JarnoBoks/spacemouse/pcb/esp32s3zero - rev1.0/PCB_CAD-Mouse_rev1.0.dxf

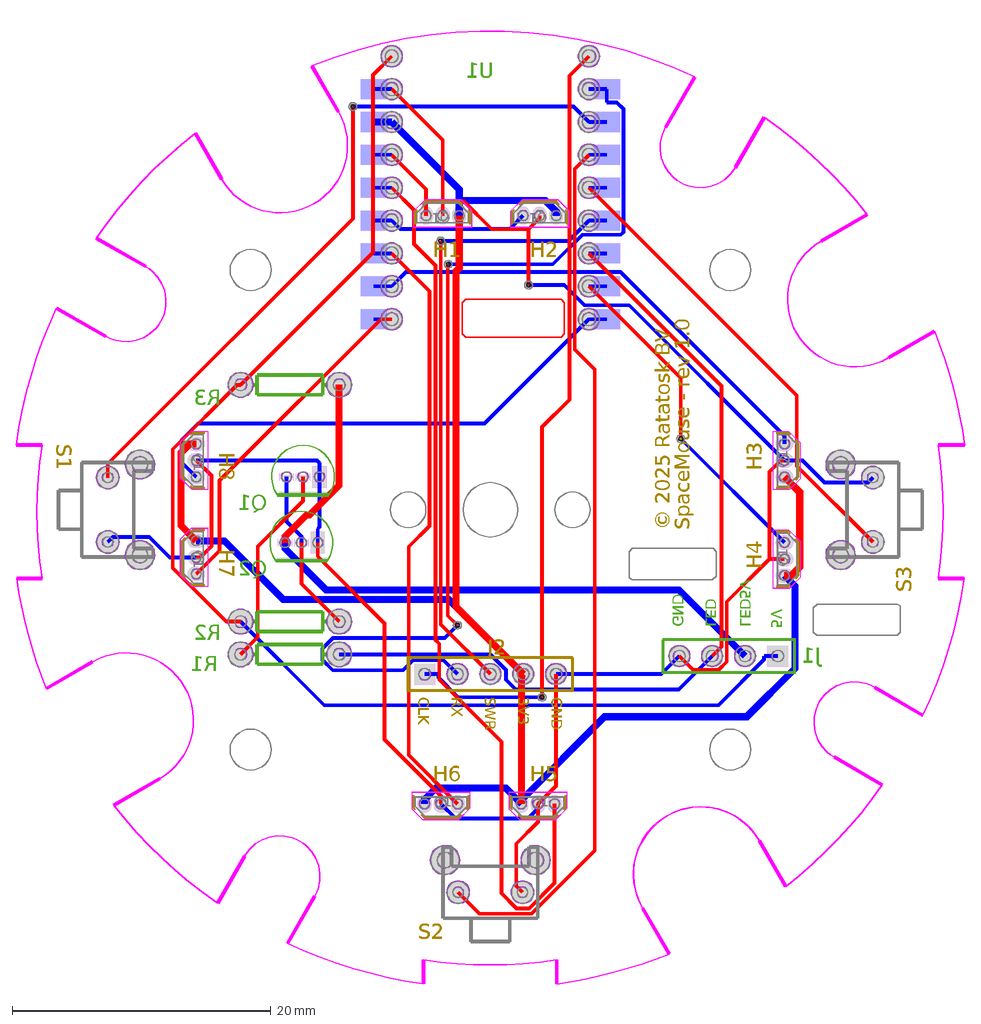
[picture p1: CAD file, 2025-06-10]
pcb/esp32s3zero - rev1.0/PCB_CAD-Mouse_rev1.0.dxf
LED
LED5V
5V
GND
CLK
RX
SWR
3V3
SpaceMouse - rev 1.0
© 2025 Ratatosk BV
U1
Q1
Q2
R1
R2
R3
H1
H2
H3
H4
H5
H6
H7
H8
J1
J2
S1
S2
S3
