JarnoBoks/spacemouse/stl/Spacer - PCB Sensorplate.stl

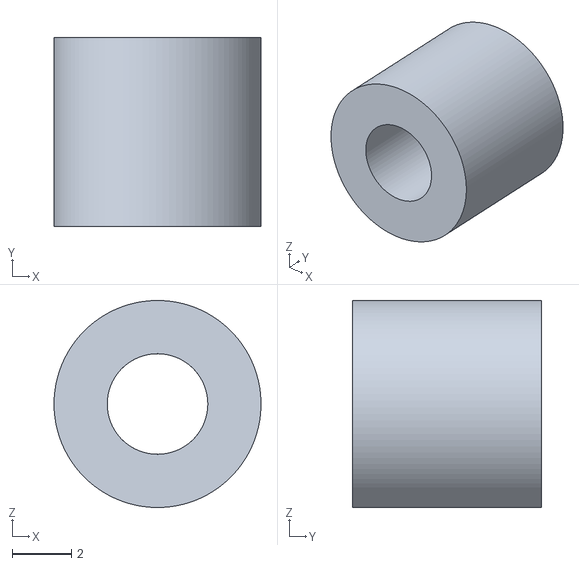
[picture p2: CAD file, 2025-06-10]
stl/Spacer - PCB Sensorplate.stl
7.00 x 6.40 x 7.00
