JarnoBoks/spacemouse/stl/Modified Arduino Plate.stl

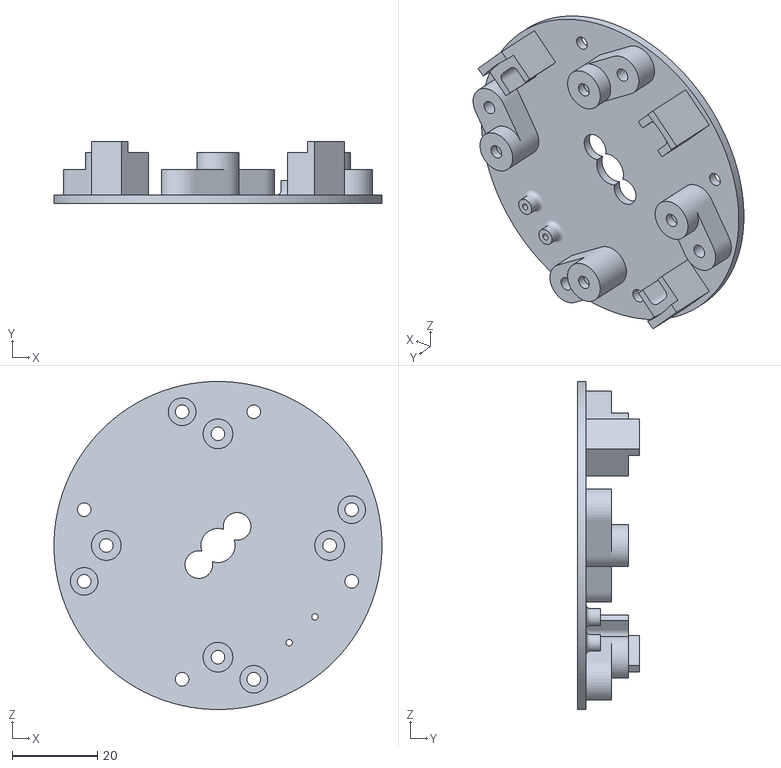
[picture p3: CAD file, 2025-06-10]
stl/Modified Arduino Plate.stl
77.0 x 14.5 x 77.0
