JarnoBoks/spacemouse/stl/Bolt mount.stl

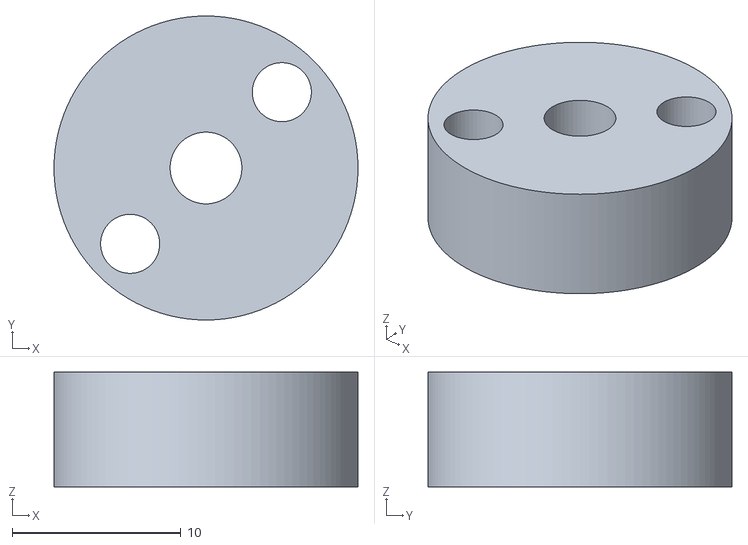
[picture p4: CAD file, 2025-06-10]
stl/Bolt mount.stl
18.0 x 18.0 x 6.80
