JarnoBoks/spacemouse/pcb/esp32s3zero - rev1.0/Gerber_CAD-Mouse_PCB_CAD-Mouse_2025-05-26/How-to-order-PCB.txt

How to Order PCB

Please refer to:
https://docs.easyeda.com/en/PCB/Order-PCB
