JarnoBoks/spacemouse/pcb/esp32s3zero - rev1.0/Schematic_CAD-Mouse_2025-05-26.pdf

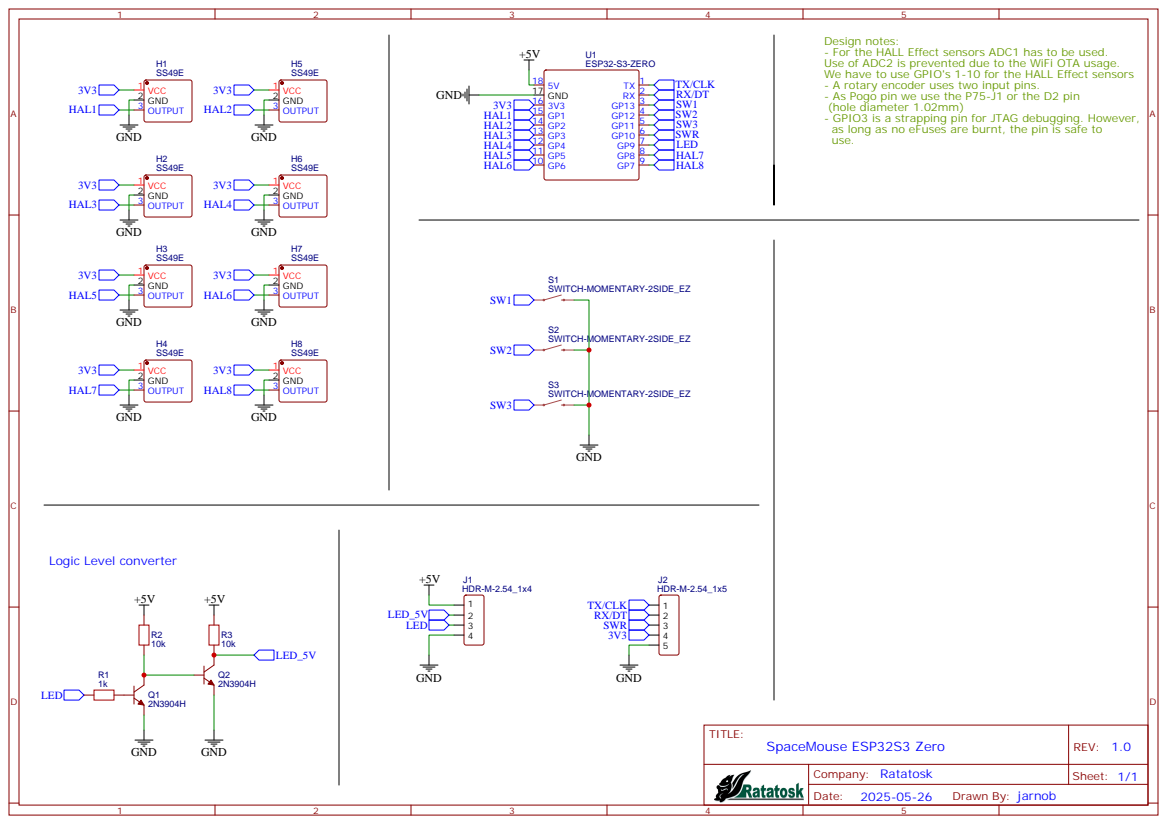
[picture p5: page 1]

Design notes:
- For the HALL Effect sensors ADC1 has to be used.
Use of ADC2 is prevented due to the WiFi OTA usage.
We have to use GPIO's 1-10 for the HALL Effect sensors
- A rotary encoder uses two input pins.
- As Pogo pin we use the P75-J1 or the D2 pin
(hole diameter 1.02mm)
- GPIO3 is a strapping pin for JTAG debugging. However,
as long as no eFuses are burnt, the pin is safe to
use.
