JarnoBoks/spacemouse/(list of files, drawings)

Other design files:
pcb/esp32s3zero - rev1.0/EasyEda SCH_CAD-Mouse_2025-05-26.json
