JarnoBoks/spacemouse/src/sensor/sensors/Sensor.cpp

#include "Sensor.hpp"
#include <sensor/config/SensorConfig.hpp>
#include <sensor/sensors/ArchitectureADC.hpp> // Abstraction from Architecture specific ADC functions

#include <wiring_private.h> // for 'map' function

/**
 * @brief Constructor for Sensor.
 * @details Initializes the sensor with the provided pin and ID.
 *          The constructor also creates a new SensorConfig object for this axis.
 * @param pin The pin number for the sensor.
 * @param id The ID of the sensor.
 */
Sensor::Sensor(const int8_t pin, const int8_t id)
    : pin(pin),
      id(id),
      config(new SensorConfig(this)) {

    // Configure this sensor's pin for ADC reading
    ArchitectureADC::connectADC(pin);

    // Read the ADC value from the pin to stabilize the ADC reading
    readValue();
}

Sensor::~Sensor() {
    delete config;
}

/**
 * @brief Checks if the provided descriptor matches the sensor's descriptor.
 * @param descriptor The descriptor to compare against the sensor's descriptor.
 * @return True if the descriptors match, false otherwise.
 */
const bool Sensor::hasDescriptor(const char *descriptor) const {
    if (this->descriptor != nullptr) {
        return (strcmp(this->descriptor, descriptor) == 0);
    }
    return false;
}

/**
 * @brief Reads the raw value from the sensor pin and applies centering if the configuration is set.
 * @details This function reads the analog value from the specified pin and calculates the centered value.
 *          If a configuration is set, it adjusts the centered value based on the idle position.
 */
void Sensor::readValue() {
    m_rawValue = ArchitectureADC::readADC(pin);

    if (config) { // REVIEW - Why the check for config?
        m_cntValue = m_rawValue - m_idleposition;
    }
}

/**
 * @brief Sets the idle position for the sensor.
 * @note This function should be called by descendants.
 *       It is intended to be overridden by derived classes to implement specific idle position logic.
 * @param val The new idle position to set.
 * @return False if any warning occurs, True otherwise.
 */
bool Sensor::setIdlePosition(int val) {
    m_idleposition = val; // Set the idle position to the provided value
    if (config) {
        config->processCenterChange(val); // Adjust the min and max values in the configuration based on the new idle position
    }
    return true; // Return true to indicate success
}

/**
 * @brief Sets the deadzone for the sensor.
 * @note This function is a placeholder and does not perform any validation.
 *       It is intended to be overridden by derived classes to implement specific deadzone logic.
 * @param val The new deadzone to set.
 * @return False if no warning occurs, True otherwise.
 */
bool Sensor::setDeadzone(const uint8_t dz) {
    m_deadzone = dz; // Set the deadzone to the provided value
    return true;     // Return true to indicate success
}

/**
 * @brief Applies calibration values (deadzone, min/max & inversion) to the sensor value.
 * @details This function sets the final value of the reading based on the sensor's configuration.
 *          Apply deadzone correction, mapping, and inversion based on the configuration
 *          If the absolute value of the centered value is within the deadzone, set the final value to 0
 *          If the centered value is greater than the deadzone, map it to a positive range
 *          If the centered value is less than the negative deadzone, map it to a negative range
 *          The mapping is done to a range of -TOTALSENSITIVITY to TOTALSENSITIVITY
 */
#define TOTALSENSITIVITY 350
void Sensor::applyCalibration() {
    m_finValue = m_cntValue;

    if (!config) {
        return; // If no configuration is set, exit the function
    }

    if (abs(m_cntValue) <= m_deadzone) {
        m_finValue = 0;
    } else if (m_cntValue > 0) {
        // Map the positive centered value to a range of 0 to TOTALSENSITIVITY
        // long map(long x, long in_min, long in_max, long out_min, long out_max) {
        m_finValue = map(m_cntValue, m_deadzone, config->getMax(), 0, TOTALSENSITIVITY);
    } else {
        // Map the negative centered value to a range of -TOTALSENSITIVITY to 0
        // long map(long x, long in_min, long in_max, long out_min, long out_max) {
        m_finValue = map(abs(m_cntValue), m_deadzone, abs(config->getMin()), 0, TOTALSENSITIVITY) * -1;
        // m_finValue = map(m_cntValue, config->getMin(), (-1 * m_deadzone), -TOTALSENSITIVITY, 0);
    }

    // Invert the final value if the configuration is set to inverted
    m_finValue = (config->isInverted()) ? -m_finValue : m_finValue;
}
