JarnoBoks/spacemouse/spacemouse-keys/encoderWheel.h

#ifndef ENCODERWHEEL_H
#define ENCODERWHEEL_H
// Header file for the encoderWheel.cpp

#include <Arduino.h>
#include "config.h"
#include "..\src\kinematics\Kinematics.hpp"
#include "spaceKeys.h"

void initEncoderWheel();
void calcEncoderWheel(Kinematics &SMKIN, int debug);
void calcEncoderAsKey(SpaceKeys *SMKEYS, int debug);

#endif // ENCODERWHEEL_H
