JarnoBoks/spacemouse/src/defaults_hall.h

#pragma once

/**
 * Default configuration for the HALL Effect hardware.
 *
 * This file contains the default configuration settings for the HALL Effect sensor hardware.
 * The values are used to set the default configuration for the HALL Effect axes as well as the sensors for the spacemouse.
 * The values can be overridden by the user in the config.h file.
 * The default values are used if there isn't a configuration in the EEPROM or if the EEPROM version is changed.
 */

#include "config.h" // Include the config.h file to check for overrides.

// --------------------- SENSOR DEFAULTS -------------------------

#ifndef PINLIST
// The pinlist should be defined in the config.h file, but if not, we define it here for failsafe purposes although the software behaviour will be undefined.
#define PINLIST {A0, A1, A2, A3, A6, A7, A8, A9}
#endif

#ifndef INVERTLIST
// The invertlist should be defined in the config.h file, but if not, we define it here for failsafe purposes although the software behaviour will be undefined.
#define INVERTLIST {0, 0, 0, 0, 0, 0, 0, 0}
#endif

// MIN and MAX values for the HALL sensors
#ifndef MINVALS
// #define MINVALS {-437, -385, -511, -373, -407, -321, -347, -330}  // Arduino Pro Micro version
#define MINVALS {-512, -512, -512, -512, -512, -512, -512, -512}
#endif
#ifndef MAXVALS
// #define MAXVALS {131, 166, 100, 168, 186, 250, 215, 235}          // Arduino Pro Micro version
#define MAXVALS {512, 512, 512, 512, 512, 512, 512, 512}
#endif

// Electric zeroes for the HALL sensors - these are the values that the sensors read when there are no magnets present.
// TODO - Write calibration instructions and software to determine these values and store them in the EEPROM.
// REVIEW - Is this necessary? The sensors should be calibrated to the idle position, so these values should be zero.s
#ifndef ELECTRICZEROES
#define ELECTRICZEROES {3643, 3653, 3555, 3647, 3540, 3497, 3658, 3657} // Default electric zeroes for the HALL sensors
#endif

// ---------------------- AXES DEFAULTS --------------------------

// Default axis configuration for spacemouse with HALL sensors.
// ============================================================
#define NO_GATE 0

// --- Translation X axis (move knob east / west):
#ifndef DEF_SENS_TX_POS
#define DEF_SENS_TX_POS 0.8
#endif
#ifndef DEF_SENS_TX_NEG
#define DEF_SENS_TX_NEG 0.8
#endif

#ifndef DEF_GATE_TX_POS
#define DEF_GATE_TX_POS NO_GATE
#endif
#ifndef DEF_GATE_TX_NEG
#define DEF_GATE_TX_NEG NO_GATE
#endif

// --- Translation Y axis (move knob north / south):
#ifndef DEF_SENS_TY_POS
#define DEF_SENS_TY_POS 0.99
#endif
#ifndef DEF_SENS_TY_NEG
#define DEF_SENS_TY_NEG 0.99
#endif
#ifndef DEF_GATE_TY_POS
#define DEF_GATE_TY_POS NO_GATE
#endif
#ifndef DEF_GATE_TY_NEG
#define DEF_GATE_TY_NEG NO_GATE
#endif

// --- Translation Z axis (pushing knob down, pulling knob up):
#ifndef DEF_SENS_TZ_POS
#define DEF_SENS_TZ_POS 2.5
#endif
#ifndef DEF_SENS_TZ_NEG
#define DEF_SENS_TZ_NEG 1.5
#endif

#ifndef DEF_GATE_TZ_POS
#define DEF_GATE_TZ_POS NO_GATE
#endif
#ifndef DEF_GATE_TZ_NEG
#define DEF_GATE_TZ_NEG 15
#endif

// --- Ration X axis (tilt knob east / west):
#ifndef DEF_SENS_RX_POS
#define DEF_SENS_RX_POS 1.0
#endif
#ifndef DEF_SENS_RX_NEG
#define DEF_SENS_RX_NEG 1.0
#endif

#ifndef DEF_GATE_RX_POS
#define DEF_GATE_RX_POS 15
#endif
#ifndef DEF_GATE_RX_NEG
#define DEF_GATE_RX_NEG 15
#endif

// --- Ration Y axis (tilt knob north / south):
#ifndef DEF_SENS_RY_POS
#define DEF_SENS_RY_POS 1.2
#endif
#ifndef DEF_SENS_RY_NEG
#define DEF_SENS_RY_NEG 1.2
#endif

#ifndef DEF_GATE_RY_POS
#define DEF_GATE_RY_POS 15
#endif
#ifndef DEF_GATE_RY_NEG
#define DEF_GATE_RY_NEG 15
#endif

// --- Ration Z axis (turn knob clockwise / counterclockwise):
#ifndef DEF_SENS_RZ_POS
#define DEF_SENS_RZ_POS 0.9
#endif
#ifndef DEF_SENS_RZ_NEG
#define DEF_SENS_RZ_NEG 0.9
#endif

#ifndef DEF_GATE_RZ_POS
#define DEF_GATE_RZ_POS 15
#endif
#ifndef DEF_GATE_RZ_NEG
#define DEF_GATE_RZ_NEG 15
#endif

// --- Modifier Function
#ifndef DEF_MODFUNC
#define DEF_MODFUNC 3 // 0 = linear, 1 = squared, 2 = tangent, 3 = squared tangent, 4 = cubed tangent
#endif

#ifndef DEF_MF_TX_POS
#define DEF_MF_TX_POS DEF_MODFUNC // 0 = linear, 1 = squared, 2 = tangent, 3 = squared tangent, 4 = cubed tangent
#endif
#ifndef DEF_MF_TX_NEG
#define DEF_MF_TX_NEG DEF_MODFUNC // 0 = linear, 1 = squared, 2 = tangent, 3 = squared tangent, 4 = cubed tangent
#endif
#ifndef DEF_MF_TY_POS
#define DEF_MF_TY_POS DEF_MODFUNC // 0 = linear, 1 = squared, 2 = tangent, 3 = squared tangent, 4 = cubed tangent
#endif
#ifndef DEF_MF_TY_NEG
#define DEF_MF_TY_NEG DEF_MODFUNC // 0 = linear, 1 = squared, 2 = tangent, 3 = squared tangent, 4 = cubed tangent
#endif
#ifndef DEF_MF_TZ_POS
#define DEF_MF_TZ_POS 0 // 0 = linear, 1 = squared, 2 = tangent, 3 = squared tangent, 4 = cubed tangent
#endif
#ifndef DEF_MF_TZ_NEG
#define DEF_MF_TZ_NEG DEF_MODFUNC // 0 = linear, 1 = squared, 2 = tangent, 3 = squared tangent, 4 = cubed tangent
#endif
#ifndef DEF_MF_RX_POS
#define DEF_MF_RX_POS DEF_MODFUNC // 0 = linear, 1 = squared, 2 = tangent, 3 = squared tangent, 4 = cubed tangent
#endif
#ifndef DEF_MF_RX_NEG
#define DEF_MF_RX_NEG DEF_MODFUNC // 0 = linear, 1 = squared, 2 = tangent, 3 = squared tangent, 4 = cubed tangent
#endif
#ifndef DEF_MF_RY_POS
#define DEF_MF_RY_POS DEF_MODFUNC // 0 = linear, 1 = squared, 2 = tangent, 3 = squared tangent, 4 = cubed tangent
#endif
#ifndef DEF_MF_RY_NEG
#define DEF_MF_RY_NEG DEF_MODFUNC // 0 = linear, 1 = squared, 2 = tangent, 3 = squared tangent, 4 = cubed tangent
#endif
#ifndef DEF_MF_RZ_POS
#define DEF_MF_RZ_POS DEF_MODFUNC // 0 = linear, 1 = squared, 2 = tangent, 3 = squared tangent, 4 = cubed tangent
#endif
#ifndef DEF_MF_RZ_NEG
#define DEF_MF_RZ_NEG DEF_MODFUNC // 0 = linear, 1 = squared, 2 = tangent, 3 = squared tangent, 4 = cubed tangent
#endif

// Setup the inversion defaults for the translation and rotation axes.
// The inversion values are used to invert the direction of the translation and rotation axes.
// 0 = no inversion, 1 = inversion

#ifndef DEF_INVERT_TX
#define DEF_INVERT_TX 1 // 0 = no inversion, 1 = inversion
#endif
#ifndef DEF_INVERT_TY
#define DEF_INVERT_TY 1 // 0 = no inversion, 1 = inversion
#endif
#ifndef DEF_INVERT_TZ
#define DEF_INVERT_TZ 1 // 0 = no inversion, 1 = inversion
#endif
#ifndef DEF_INVERT_RX
#define DEF_INVERT_RX 1 // 0 = no inversion, 1 = inversion
#endif
#ifndef DEF_INVERT_RY
#define DEF_INVERT_RY 1 // 0 = no inversion, 1 = inversion
#endif
#ifndef DEF_INVERT_RZ
#define DEF_INVERT_RZ 1 // 0 = no inversion, 1 = inversion
#endif

// --------------------- KINEMATICS DEFAULTS  ----------------------------
// The kinematics defaults are used to set the default configuration for the kinematics of the spacemouse.
// The values can be overridden by the user in the config.h file.
// Switch Zoom direction with Up/Down Movement
#ifndef DEF_SWITCHYZ
#define DEF_SWITCHYZ 0 // 1: Y and Z axes are switched, 0: Y and Z axes are not switched
#endif
#ifndef DEF_EXCLUSIVEMODE
#define DEF_EXCLUSIVEMODE 1 // 1: Exclusive mode enabled, 0: Exclusive mode disabled    // FIXME - Change to 0 to disable the exclusive mode by default
#endif

// ------------------ PREPOCESSOR DIRECTIVES USED IN THE SOFTWARE
// Change the sensor warning levels if your hardware requires. Normally this isn't necessary.
#ifdef ARCH_ARDUINO_PRO_MICRO
// The Arduino Pro Micro has a ADC range of 0-1023, so we need to adjust the warning levels accordingly.
#define IDLEPOINT_LOW_WARNINGLEVEL 600  // The idlePoint should be above this level.
#define IDLEPOINT_HIGH_WARNINGLEVEL 800 // The idlePoint should be below this level.

#define DEADZONE_WARNINGLEVEL 10 // The deadzone should be below this level.
#define DEADZONE_SURPLUS 2       // The surplus that will be added to the calibrated value of the deadzone. This is used to prevent the deadzone from being too small.

#define MINIMUM_HIGH_WARNINGLEVEL -275 // The minimum value for the sensor should be below this level.
#define MAXIMUM_LOW_WARNINGLEVEL 175   // The maximum value for the sensor should be above this level.

#define WORKINGRANGE_WARNINGLEVEL 500 // The working range of the sensor should be above this level (ie. distance between MIN and MAX).
#endif

#ifdef ARDUINO_ARCH_ESP32
// The ESP32 has a ADC range of 0-4095, so we need to adjust the warning levels accordingly.
#define IDLEPOINT_LOW_WARNINGLEVEL 3000  // The idlePoint should be above this level.
#define IDLEPOINT_HIGH_WARNINGLEVEL 3400 // The idlePoint should be below this level.

// Deadzone values are four times higher than the Arduino Pro Micro values, because the ESP32 has a ADC range of 0-4095.
#define DEADZONE_WARNINGLEVEL 40 // The deadzone should be below this level.
#define DEADZONE_SURPLUS 8       // The surplus that will be added to the calibrated value of the deadzone. This is used to prevent the deadzone from being too small.

#define MINIMUM_HIGH_WARNINGLEVEL -1200 // The minimum value for the sensor should be below this level.
#define MAXIMUM_LOW_WARNINGLEVEL 400    // The maximum value for the sensor should be above this level.

#define WORKINGRANGE_WARNINGLEVEL 1800 // The working range of the sensor should be above this level (ie. distance between MIN and MAX).
#endif
