JarnoBoks/spacemouse/src/commandhandler/IAxisConfigCommand.h

#pragma once

#include "CommandBase.h"

#define NUM_AX_DIRCFG 2 // Number of axis direction configurations per AxisConfig in the software (Current: Positive and Negative)

class AxisDirectionConfig;
class Axis;

/**
 * @brief   Interface for axis configuration commands.
 * @details This interface defines the structure for commands that configure axis settings.
 *          It includes methods for executing commands with parameters.
 * @note    Derived classes should override the execute method, and call the Baseclass functionality.
 */
class IAxisConfigCommand : public CommandBase {
private:
protected:
    AxisDirectionConfig *m_AxisDirectionConfig[NUM_AX_DIRCFG]; // Array of pointers to AxisDirectionConfig objects
    Axis *m_Axis = nullptr;                                    // Pointer to the Axis object that will be configured
    float m_requestedValue = 0;                                // Requested value for the axis configuration (sensitivity, gate, etc.) derived from the command. -1 if no update is needed.

public:
    /**
     * @brief Constructor for the SensCommand class.
     * @param collectionCarrier Pointer to the CollectionCarrier for accessing collections.
     * @details Initializes the command with the CMD_SENS command name.
     */
    // TODO - Make the collectionCarrier a const reference
    IAxisConfigCommand(const char *cmdName, CollectionCarrier *collectionCarrier) : CommandBase(cmdName, collectionCarrier) {
        for (uint8_t i = 0; i < NUM_AX_DIRCFG; i++) {
            m_AxisDirectionConfig[i] = nullptr; // Initialize the axis direction configuration pointers to nullptr
        }
    }
    virtual ~IAxisConfigCommand() {};

    virtual void execute(const char *param1, const char *param2, uint8_t paramCount) override;
};
