JarnoBoks/spacemouse/src/commandhandler/showcommand.h

// showcommand.h
#pragma once

#include "CommandBase.h"

/// @brief command text for the Show command
static const char CMD_SHOW[] PROGMEM = "SHOW";

class ShowCommand : public CommandBase {
private:
public:
    ShowCommand() : CommandBase(CMD_SHOW) {} // Constructor to initialize command name

    void execute(const char *param1, const char *param2, const uint8_t paramCount) override;
};
