JarnoBoks/spacemouse/src/commandhandler/ICommand.h

#pragma once
#include <Arduino.h>

// #define CF(x) ((const __FlashStringHelper *)x)

class ICommand {
private:
    const char *name; // Contains command 'name' as a PROGMEM char *
protected:
    const bool isWordEmpty(const char *str, const char *errorMsg) const; // REVIEW - Necessary to check for empty command?
    const bool convertWordNumber(const char *str, long *value) const;
    const bool convertWordFloat(const char *str, float *value) const;

public:
    ICommand() : name(nullptr) {}                    // Default constructor to initialize command name
    ICommand(const char *cmdName) : name(cmdName) {} // Constructor to initialize command name
    virtual ~ICommand() = default;

    inline const bool isCommand(const char *cmdName) const {

        // NOTE: The strcmp_P function is used to compare the command name with the provided name.
        //       It is assumed that the second parameter ('name')  is stored in program memory (PROGMEM) to save RAM space.
        return (strcmp_P(cmdName, name) == 0); // Compare command name with the provided name
    }

    virtual void execute(const char *param1, const char *param2, const uint8_t paramCount) = 0;
};
