JarnoBoks/spacemouse/src/sensor/calibrator/states/CalibratorStateIdle.hpp

#pragma once
#include "CalibratorStateBase.hpp"
#include <stdint.h> // For uint16_t type

#ifndef IDLE_ITERATIONS
#define IDLE_ITERATIONS 500 // Default number of iterations for idle calibration during startup
#endif

class CalibratorStateIdle : public CalibratorStateBase {
private:
    const uint16_t m_requestedIterations = IDLE_ITERATIONS; // Number of requested iterations for this idle calibration
    uint16_t m_processedIterations = 0;                     // Number of processed iterations for idle calibration

public:
    CalibratorStateIdle() = default;                                                      // Default constructor
    CalibratorStateIdle(const uint16_t iterations) : m_requestedIterations(iterations) {} // Parameterized constructor
    virtual ~CalibratorStateIdle() = default;

    void start() override;
    void update() override;
    void finish() override;

    inline uint16_t getRequestedIterations() const { return m_requestedIterations; } // Get the number of requested iterations
    inline uint16_t getProcessedIterations() const { return m_processedIterations; } // Get the number of processed iterations
};
