JarnoBoks/spacemouse/(commit log)

2025-04-13 Added settings for PCB Hall Effect spacemouse
    Based on the sketch that John Crombie wrote.
2025-04-14 Changed printkeys statement (and automatic code formatting)
2025-04-14 HallEffect vs Joystick abstraction
    Added hardware specific files for Joystick / Hall effect sensors
    Changed code comments & function namens to apply to both hardware
    configurations
2025-04-14 Moved ADC/hardware specific functions to their own file
2025-04-14 Merged upstream change into hall sample config.
    The upstream sample config file changed. This
    change is now reflected in the hall_e sample
    config too.
2025-04-14 Add 'busyZeroing' to the ADC HW classes
2025-04-15 Hall effect working
2025-04-20 Minmax calibration & EEPROM storage.
2025-04-20 Kinematics/HW defaults if not initialzed
2025-04-20 First changes for sample config.h
2025-04-27 Fixes after first testing
    [ICommand.h, SpaceMouseHID.cpp, commandhandler.cpp]
2025-04-28 Added calibration for idle and min/max values of the sensors
2025-04-29 Finished sensor calibration
2025-04-30 Added Ledring for size evaluation
2025-04-30 Initial setup for switchXY & Eclusivemode
2025-04-30 Added ExclusiveCommand / SwitchYZ / TextHelper
2025-04-30 First ledring changes
2025-05-01 Added button scaffold
2025-05-02 Removed old kill switch function from ino
2025-05-02 Some work in progress for the buttons
2025-05-02 Performance fix (faster ADC)
    [hardware_hall.cpp]
2025-05-03 Cleanup sensor code
2025-05-04 Fixed 'physical buttons' for the code.
2025-05-05 Renamed Button > Key
2025-05-08 Fixed HIDCommand setup for compilation
    [spacemouse-keys.ino]
2025-05-09 File structure sensor
2025-05-09 Introduced sensorCollection
2025-05-11 Fixed selecting the wrong hardware type
    [minmaxcommand.h]
2025-05-12 More fixes - memory issues stay
    [Observable.hpp, SensorIdleCalibration.cpp, SensorIdleCalibration.h, esp_print.h, spacemouse-keys.ino]
2025-05-15 ESP32 compiles
2025-05-16 fixed include paths (for linux)
    [AVRCommandHandler.cpp]
2025-05-16 Fixes for nullptr errors
    [AVRCommandHandler.cpp, AVRCommandHandler.hpp, SpaceMouseHID.h, esp_print.h]
2025-05-17 Removed print statements
2025-05-17 Added Freeram for ESP32
2025-05-17 Added Error/Warning information for debug statements
    [EspCommandHandler.cpp, EspCommandHandler.hpp, IAxisConfigCommand.h, esp_print.h, idlecommand.cpp, minmaxcommand.cpp]
2025-05-17 Fixed typos (to fix ESP compilation)
    [esp_print.h, freeRAM.h]
2025-05-17 Removed axiscontainer access from kinematics
2025-05-17 Start of fixing EEPROM - Compile errors!
    [eepromstore.cpp]
2025-05-18 fixing EEPROM - Compile error
    [eepromstore.cpp, eepromstore.h]
2025-05-18 Kinematicsconfig - move & removed singleton
2025-05-18 Fixed TODO - AVR Commandhandler
    [AVRCommandHandler.hpp]
2025-05-18 Enabled EEPROM for ESP32
2025-05-18 Renamed Visitors > Printervisitors
2025-05-18 Started development KillSwitch/Exclusive/SwitchXY
2025-05-19 Comments & names of calibrators
2025-05-19 Started creation of Kinematics abstraction
2025-05-20 Removed singleton from Kinematics
2025-05-20 Attached HID buffers to Kinematics Vectors
2025-05-22 Implemented SwitchYZ & Exclusivemode
2025-05-23 Removing print statements
2025-05-23 Hide EEPROM issue AtMega while debugging
    [eepromstore.cpp, freeRAM.h, spacemouse-keys.ino]
2025-05-23 Removed kinematics Axis object (memory issues)
    [AVRCommandHandler.cpp]
2025-05-23 Removed seperate printer visitor
2025-05-23 ESP32 debugging
2025-05-23 EEPROM Storage for ESP32
2025-05-27 Bugfix: Exclusive cmd AVR wrong text
    [AVRCommandHandler.cpp, exclusivecommand.h]
2025-05-27 Fix: Kinematics instantation without Axis
    [kinematics.cpp, spacemouse-keys.ino]
2025-05-27 Changed uploading strategy Arduino
2025-05-27 Added hardware design files
    [EasyEda SCH_CAD-Mouse_2025-05-26.json]
2025-05-27 Attached TRANS/ROT HIDobserver to KnobAxis
2025-05-28 Added ADC configuration for ESP32
2025-05-28 Working - Deadzone calibration
2025-05-28 Deadzone calibration finished
2025-05-29 Refactored entire sensorcalibration solution
2025-05-29 Added persistence to the MinMax calibration
2025-05-29 Refactor - Changed sensorname to sensordescriptor
2025-05-29 Fixed unsafe delete warning
    [CalibratorStateBase.cpp, IObserver.hpp]
2025-05-29 Fixed ADC compilation error for Arduino architecture
    [ArchitectureADC.hpp, CalibratorStateIdle.cpp, SensorsCalculatorHall.cpp]
2025-05-31 Added sensor to context of sensor instead of referencing by id
2025-05-31 Added LedRing functionality
2025-06-06 Default update rate for LedRing
2025-06-07 Added USBReady check for ESP32
2025-06-07 Removed obsolete debug print in HidStateData
2025-06-07 Added dependancies for Ledring inclusion
2025-06-10 Added Gerber files
    [Drill_NPTH_Through.DRL, Drill_PTH_Through.DRL, Drill_PTH_Through_Via.DRL, Gerber_BoardOutlineLayer.GKO, Gerber_BottomLayer.GBL, Gerber_BottomPasteMaskLayer.GBP, Gerber_BottomSilkscreenLayer.GBO, Gerber_BottomSolderMaskLayer.GBS]
2025-06-10 Added stl files for 3d printing
    [Bolt mount.stl, Modified Arduino Plate.stl, Spacer - PCB Sensorplate.stl]
2025-06-11 Disabled original led files
2025-06-11 Fix idle calibration
2025-06-11 Fix: - Align IDLE table header
    [SensorIdleDeadzonePrinter.hpp]
2025-06-11 Fix - Sensor deadzone type to uint8_t
    [SensorIdleCalibration.cpp, SensorIdleCalibrationResultPrinter.hpp]
2025-06-11 Moved deadzone to sensor, fixed idle calibration on boot
    [CalibratorStateIdle.cpp, CalibratorStateIdle.hpp, CalibratorStateMinMax.cpp, HallSensor.cpp, HallSensor.hpp, JoystickSensor.cpp, JoystickSensor.hpp, Sensor.cpp]
2025-06-12 Added comments to sensor.hpp
2025-06-12 Renamed SensorIdleCalibration Observer
2025-06-12 Added start of SensorIdleCalibration
2025-06-13 Fixed sensorcfg eeprom storage
    [CalibratorStateMinMax.cpp, HallSensor.cpp, HallSensor.hpp, JoystickSensor.cpp, JoystickSensor.hpp, Sensor.hpp]
2025-06-13 Fixed layout minmax printer
    [SensorMinMaxPrinter.hpp]
2025-06-13 Fixed MINMAX for single sensor
    [AVRCommandHandler.cpp, minmaxcommand.cpp]
2025-06-14 Changed hall warning level MINMAX
2025-07-13 Various fixes for ESP version
    [ArchitectureADC.hpp, HallSensor.hpp, SensorIdleCalibration.cpp, SensorsCalculatorHall.cpp, defaults_hall.h, defaults_joystick.h]
2025-07-17 Added Preferences Setup for ESP32
2025-07-17 Fixed warning output on ESP32
    [esp_print.h]
2025-07-17 Added default settings for Arduino & ESP32 PCB
2025-07-17 Updated IDLE calibration serial output
